GOROman/claude-pcb/docs/img/render-top.png

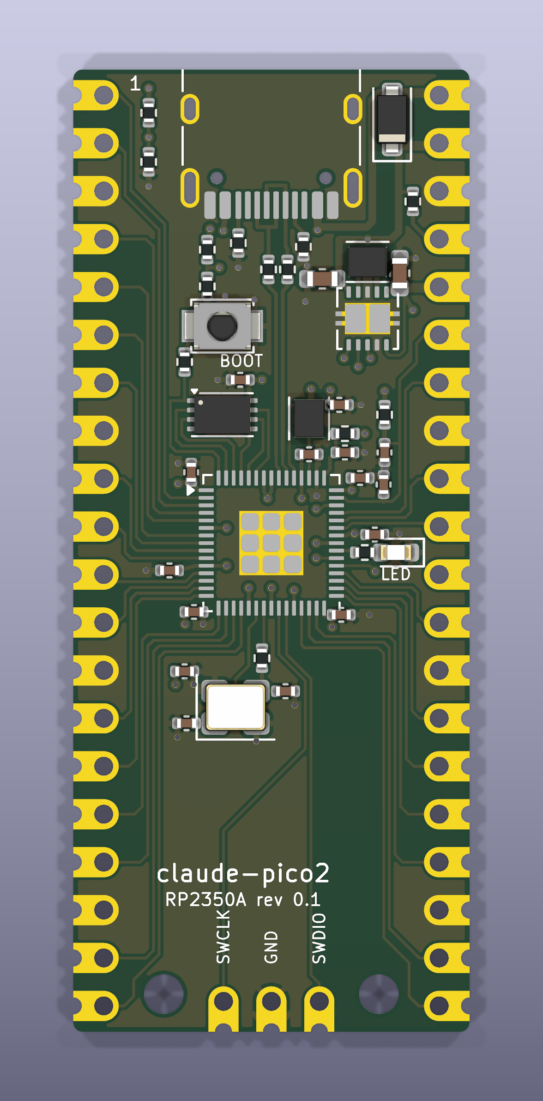
docs/img/render-top.png
