GOROman/claude-pcb/docs/img/render-iso.png

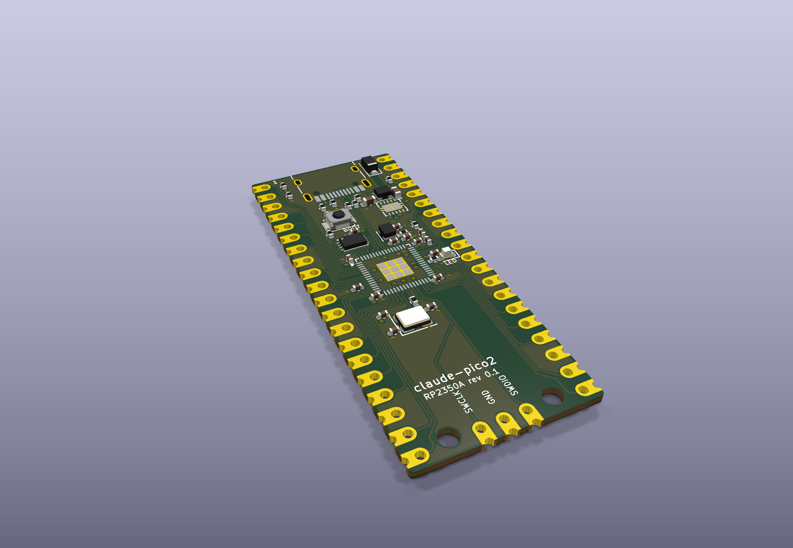
docs/img/render-iso.png
