GOROman/claude-pcb/docs/img/layer-BCu.png

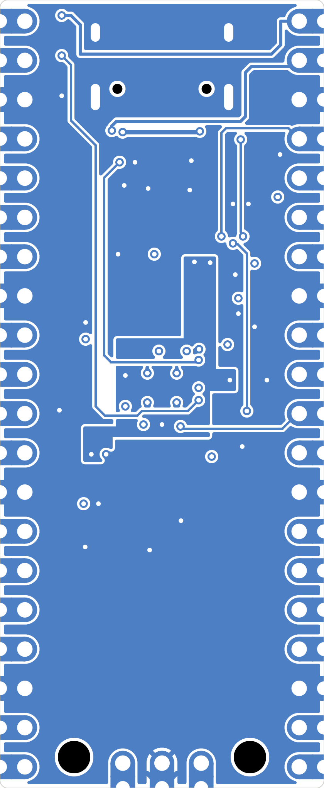
docs/img/layer-BCu.png
