GOROman/claude-pcb/docs/img/layer-FCu.png

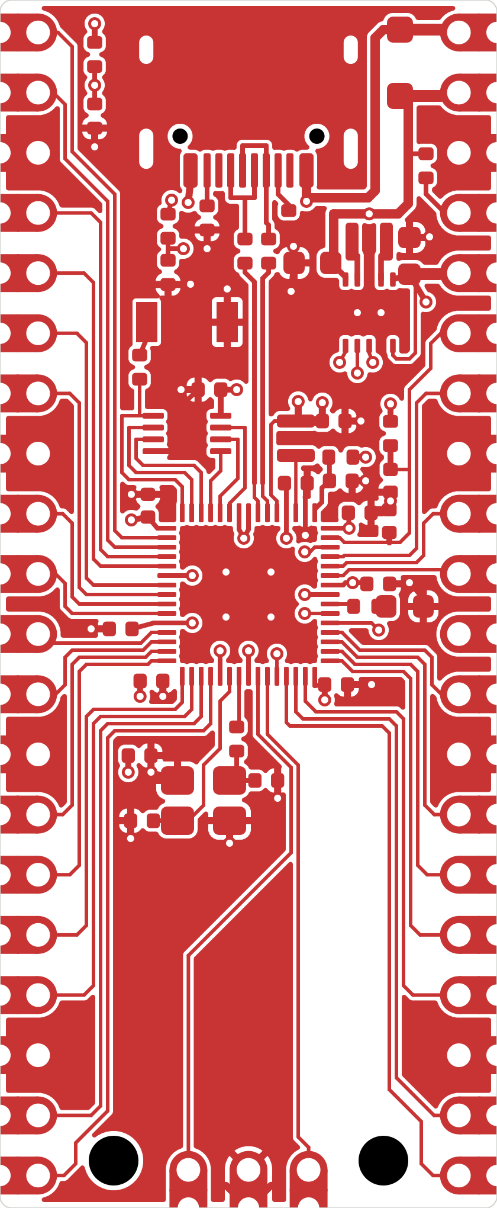
docs/img/layer-FCu.png
