GOROman/claude-pcb/docs/img/layer-In1Cu.png

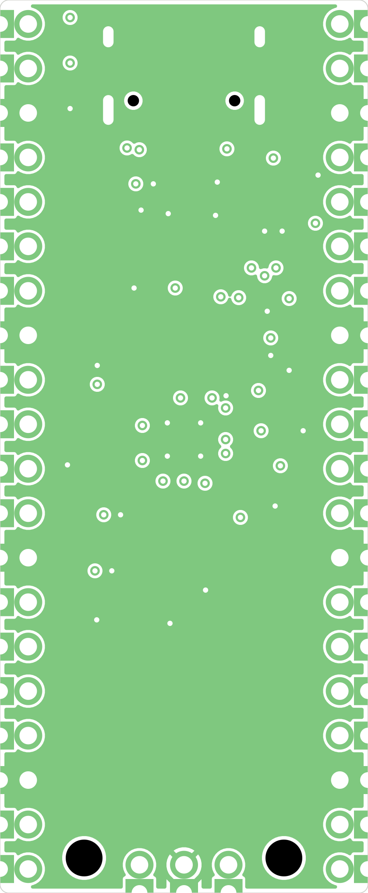
docs/img/layer-In1Cu.png
