GOROman/claude-pcb/docs/img/layer-In2Cu.png

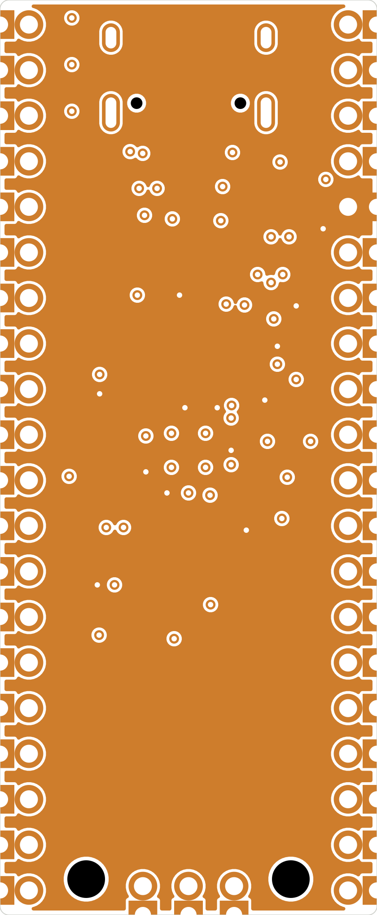
docs/img/layer-In2Cu.png
