GOROman/claude-pcb/docs/img/render-bottom.png

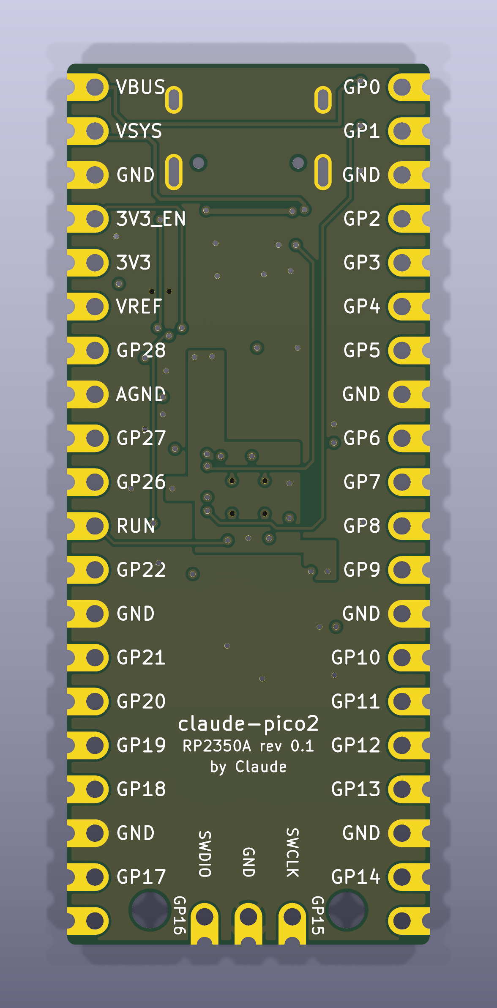
docs/img/render-bottom.png
