GOROman/claude-pcb/docs/img/schematic.png

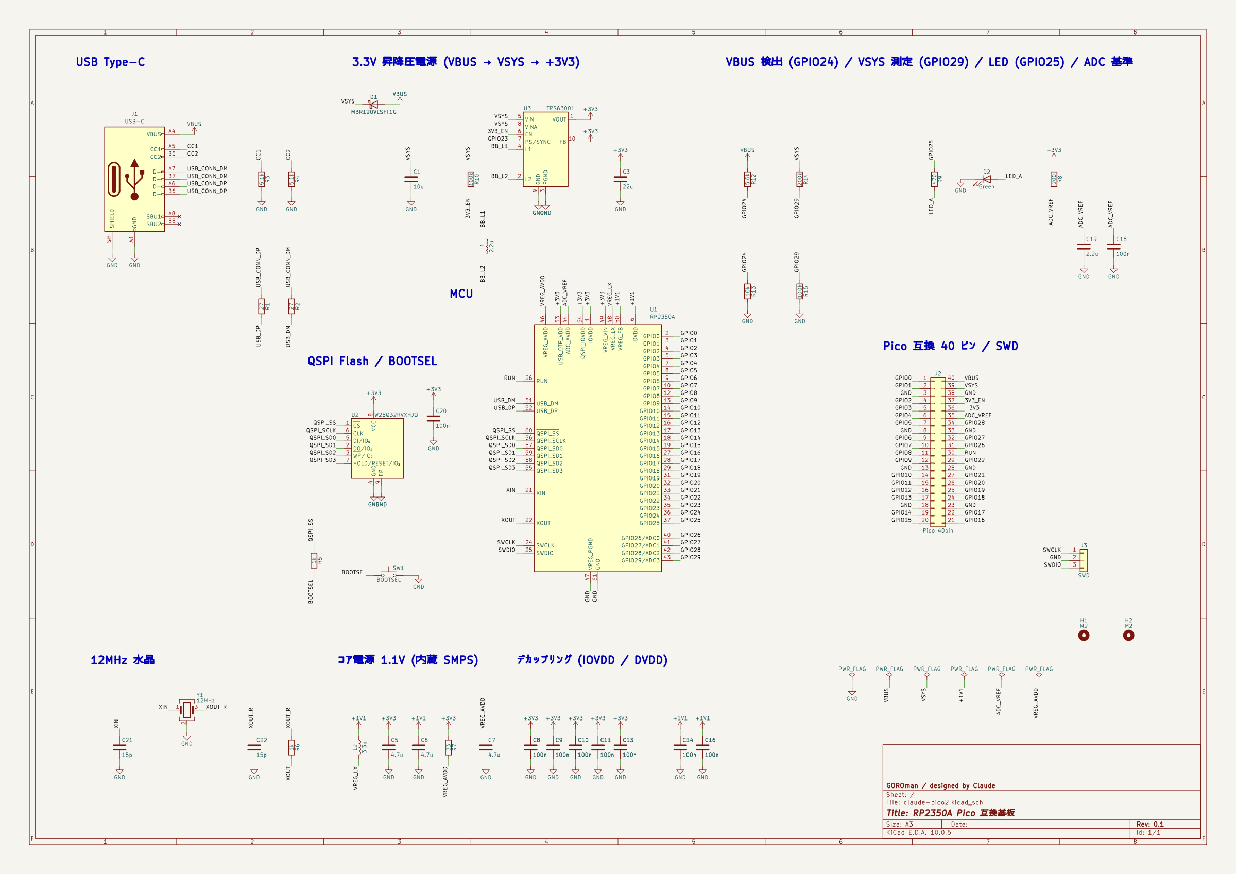
docs/img/schematic.png
