GOROman/claude-pcb/hardware/production/claude-pico2-bom.csv

Reference | Value | Footprint | MPN | Qty
C1 | 10u | Capacitor_SMD:C_0603_1608Metric |  | 1
C3 | 22u | Capacitor_SMD:C_0603_1608Metric |  | 1
C5,C6,C7 | 4.7u | Capacitor_SMD:C_0402_1005Metric |  | 3
C8,C9,C10,C11,C13,C14,C16,C18,C20 | 100n | Capacitor_SMD:C_0402_1005Metric |  | 9
C19 | 2.2u | Capacitor_SMD:C_0402_1005Metric |  | 1
C21,C22 | 15p | Capacitor_SMD:C_0402_1005Metric |  | 2
D1 | MBR120VLSFT1G | Diode_SMD:D_SOD-123F | MBR120VLSFT1G | 1
D2 | Green | LED_SMD:LED_0603_1608Metric |  | 1
J1 | USB-C | Connector_USB:USB_C_Receptacle_HRO_TYPE-C-31-M-12 | TYPE-C-31-M-12 | 1
J2 | Pico 40pin | claude_pico:PicoEdge_40 |  | 1
J3 | SWD | claude_pico:PicoDebug_3 |  | 1
L1 | 2.2u | Inductor_SMD:L_Murata_DFE201610P | DFE201612E-2R2M | 1
L2 | 3.3u | Inductor_SMD:L_Murata_DFE201610P | AOTA-B201610S3R3-101-T | 1
R1,R2 | 27 | Resistor_SMD:R_0402_1005Metric |  | 2
R3,R4 | 5.1k | Resistor_SMD:R_0402_1005Metric |  | 2
R5,R6 | 1k | Resistor_SMD:R_0402_1005Metric |  | 2
R7 | 33 | Resistor_SMD:R_0402_1005Metric |  | 1
R8 | 200 | Resistor_SMD:R_0402_1005Metric |  | 1
R9 | 470 | Resistor_SMD:R_0402_1005Metric |  | 1
R10,R15 | 100k | Resistor_SMD:R_0402_1005Metric |  | 2
R12 | 5.6k | Resistor_SMD:R_0402_1005Metric |  | 1
R13 | 10k | Resistor_SMD:R_0402_1005Metric |  | 1
R14 | 200k | Resistor_SMD:R_0402_1005Metric |  | 1
SW1 | BOOTSEL | Button_Switch_SMD:SW_SPST_B3U-1000P | B3U-1000P | 1
U1 | RP2350A | Package_DFN_QFN:QFN-60-1EP_7x7mm_P0.4mm_EP3.4x3.4mm | RP2350A | 1
U2 | W25Q32RVXHJQ | Package_SON:Winbond_USON-8-1EP_3x2mm_P0.5mm_EP0.2x1.6mm | W25Q32RVXHJQ | 1
U3 | TPS63001 | Package_SON:Texas_DRC0010J | TPS63001DRCR | 1
Y1 | 12MHz | Crystal:Crystal_SMD_3225-4Pin_3.2x2.5mm | ABM8-272-T3 | 1
