GOROman/claude-pcb/docs/schematic.pdf

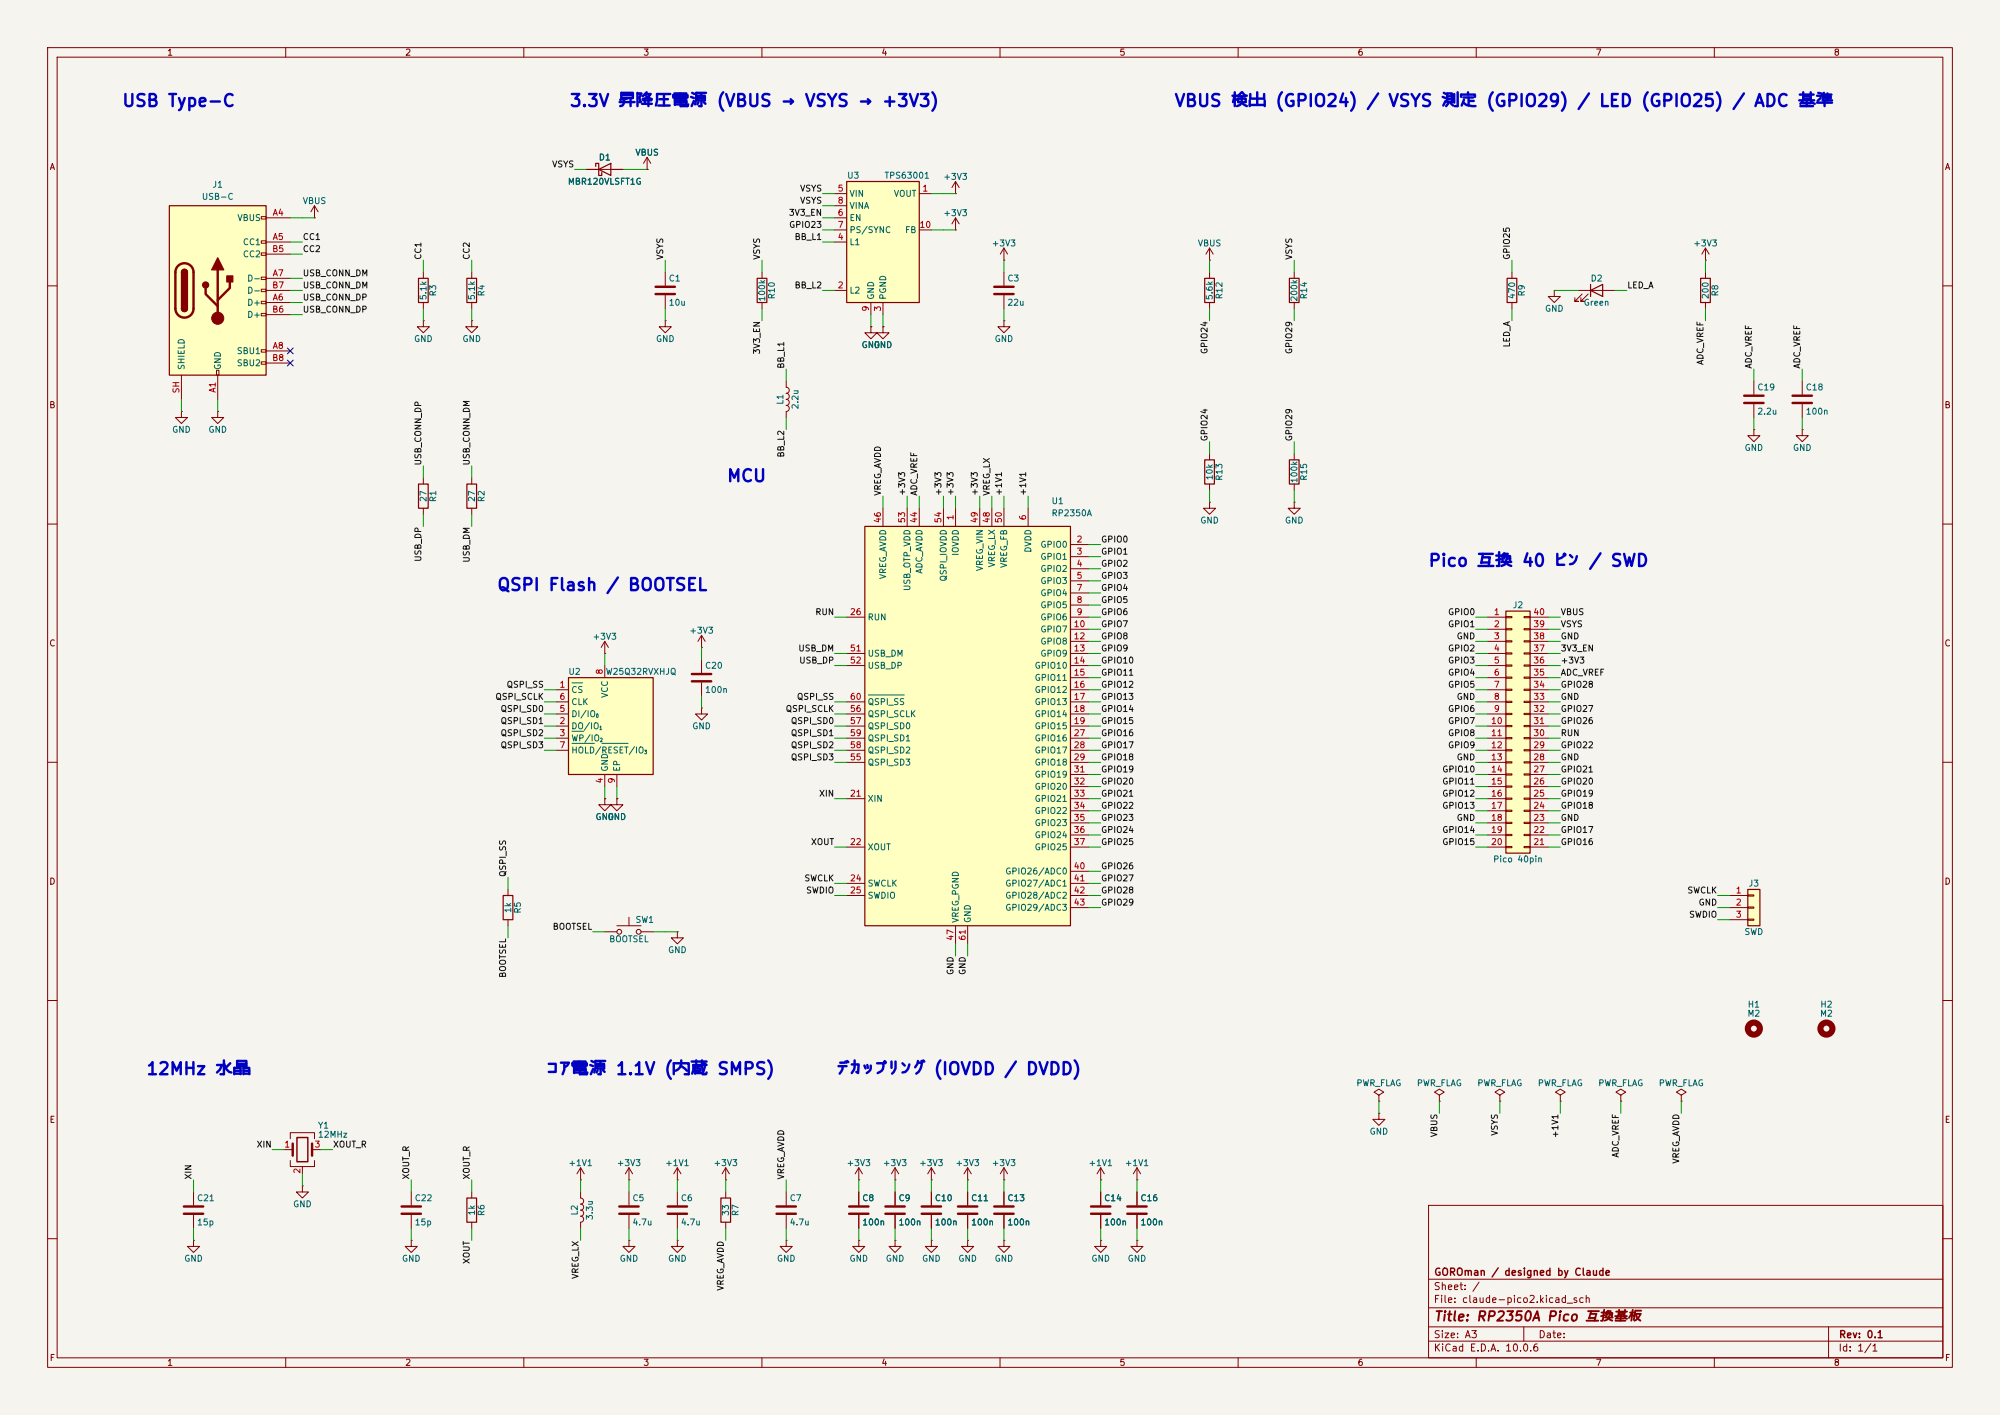
[picture p9: page 1]

VBUS 検出 (GPIO24) / VSYS 測定 (GPIO29) / LED (GPIO25) / ADC 基準

Pico 互換 40 ピン / SWD

4 DI/IO0 5 CLK 6 HOLD/RESET/IO3 7 VCC

GOROman / designed by Claude
Sheet: /
File: claude-pico2.kicad_sch
Title: RP2350A Pico 互換基板

Size: A3 | Rev: 0.1 | F Date:
KiCad E.D.A. 10.0.6 | Id: 1/1
