GOROman/claude-pcb/hardware/claude-pico2.kicad_pcb

## KiCad design hardware/claude-pico2.kicad_pcb (2026-11-10)

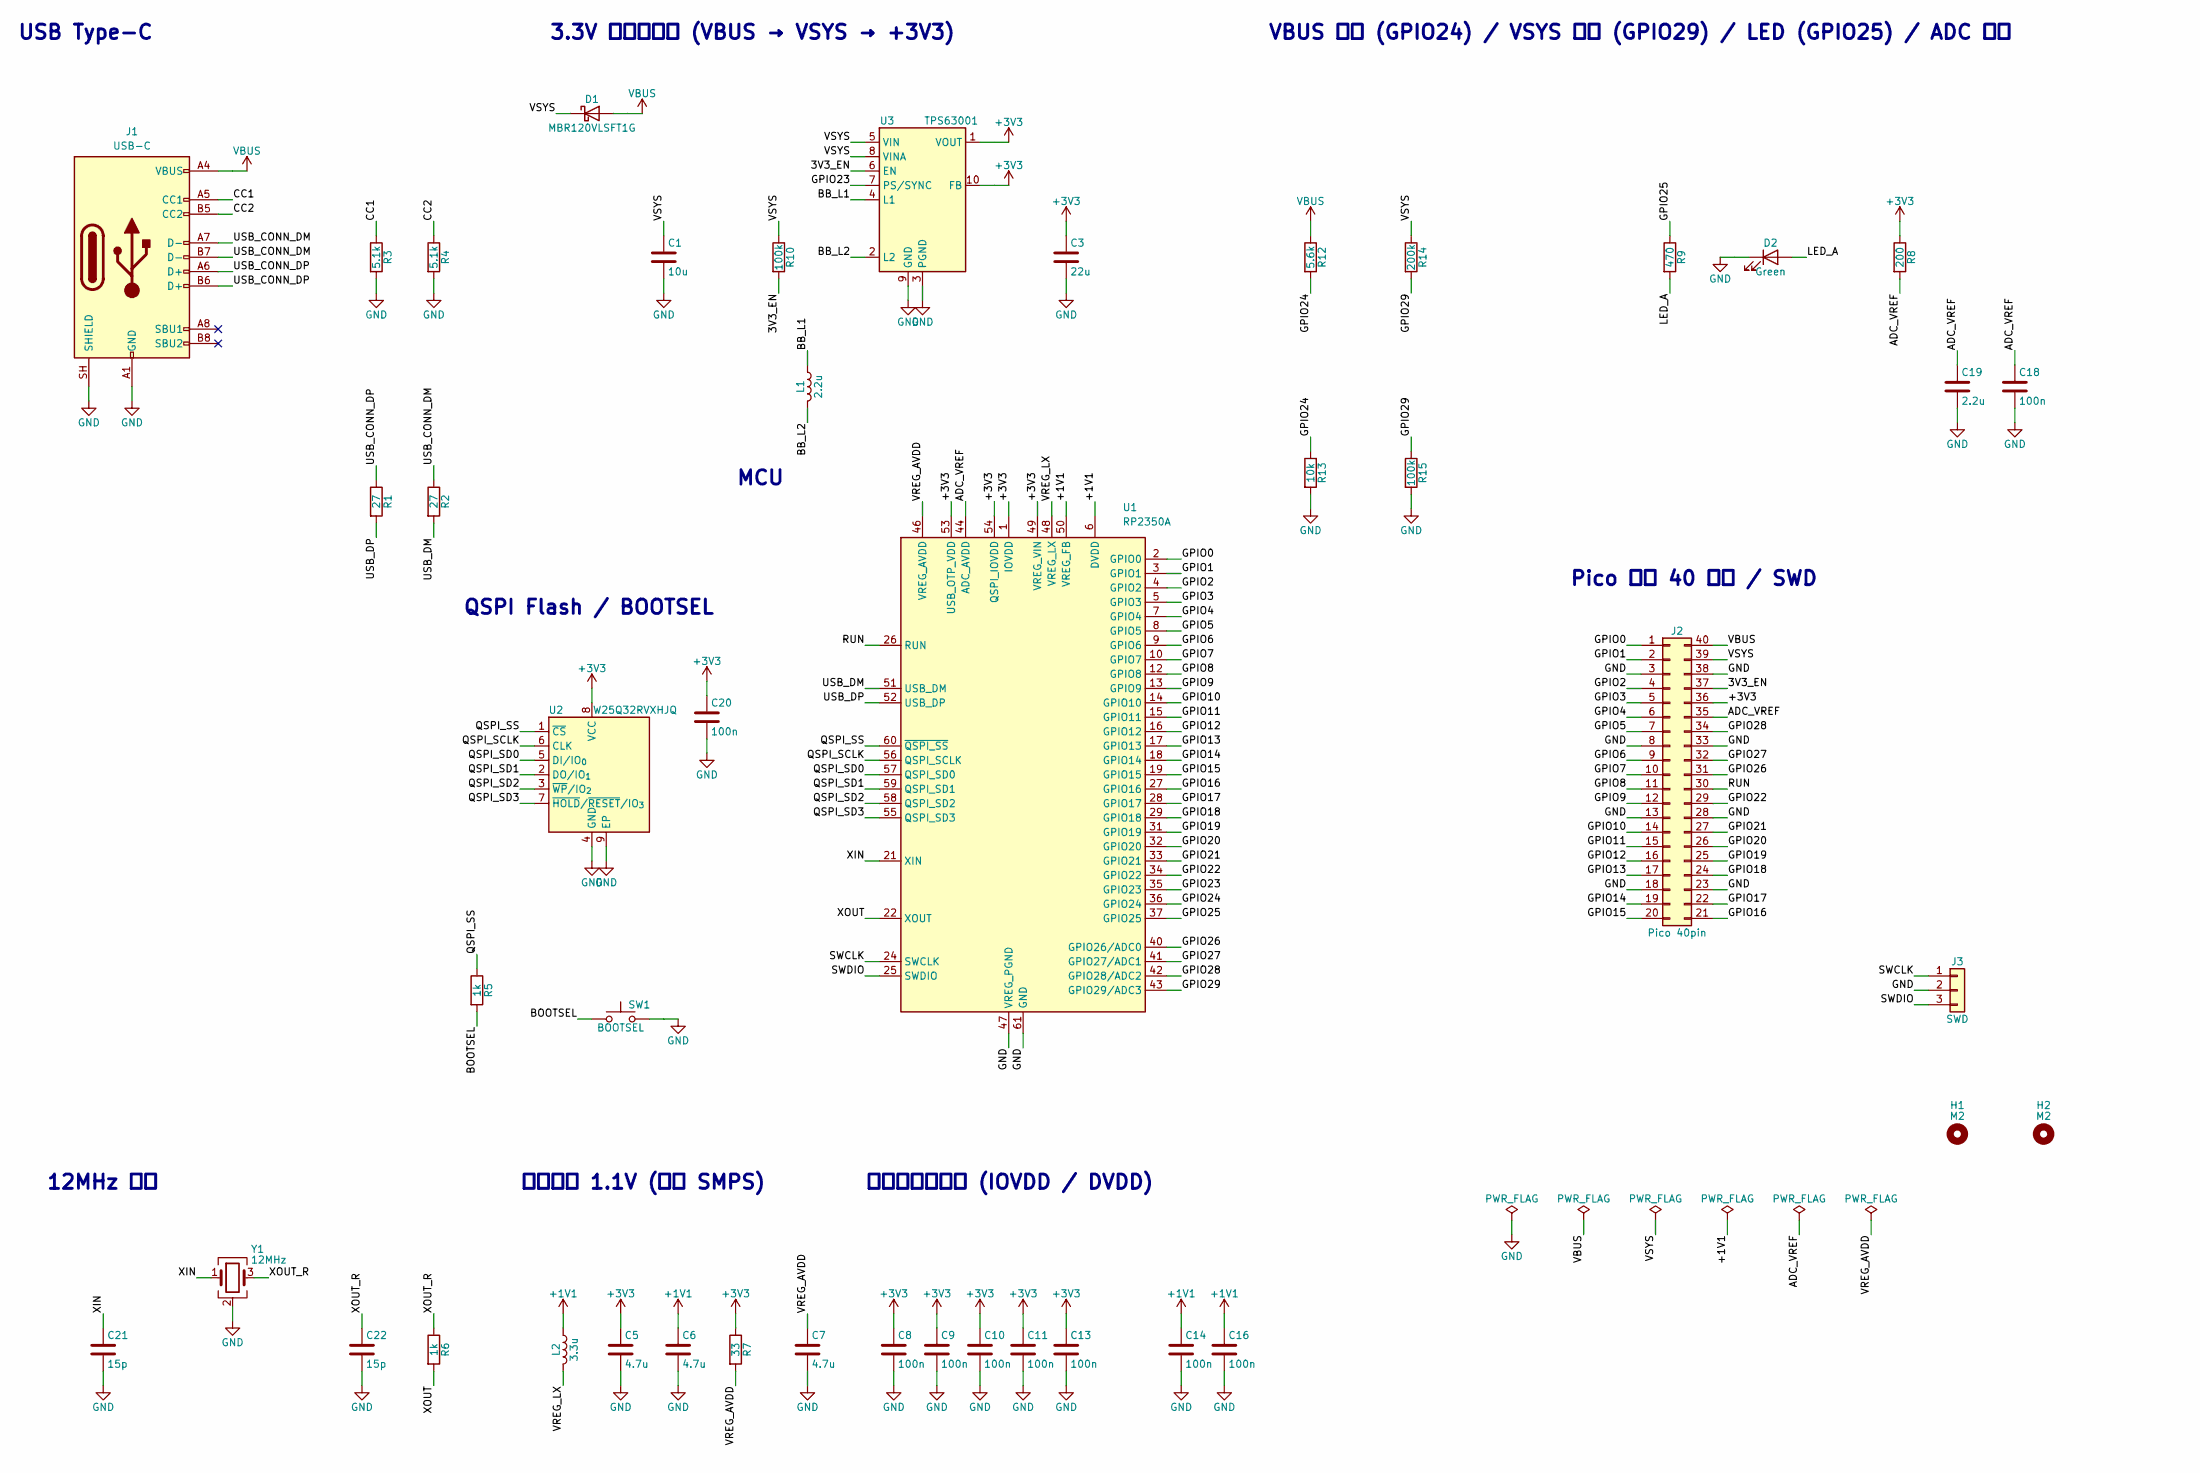
[picture p10: schematic claude-pico2.kicad_sch, RP2350A Pico 互換基板]

Parts:
C1: 10u; C_0603_1608Metric
C3: 22u; C_0603_1608Metric
C5, C6, C7: 4.7u; C_0402_1005Metric
C8, C9, C10, C11, C13, C14, C16, C18, C20: 100n; C_0402_1005Metric
C19: 2.2u; C_0402_1005Metric
C21, C22: 15p; C_0402_1005Metric
D1: MBR120VLSFT1G; D_SOD-123F; MPN MBR120VLSFT1G
D2: Green; LED_0603_1608Metric
H1, H2: M2; MountingHole_2.1mm
J1: USB-C; USB_C_Receptacle_HRO_TYPE-C-31-M-12; MPN TYPE-C-31-M-12
J2: Pico 40pin; PicoEdge_40
J3: SWD; PicoDebug_3
L1: 2.2u; L_Murata_DFE201610P; MPN DFE201612E-2R2M
L2: 3.3u; L_Murata_DFE201610P; MPN AOTA-B201610S3R3-101-T
R1, R2: 27; R_0402_1005Metric
R3, R4: 5.1k; R_0402_1005Metric
R5, R6: 1k; R_0402_1005Metric
R7: 33; R_0402_1005Metric
R8: 200; R_0402_1005Metric
R9: 470; R_0402_1005Metric
R10, R15: 100k; R_0402_1005Metric
R12: 5.6k; R_0402_1005Metric
R13: 10k; R_0402_1005Metric
R14: 200k; R_0402_1005Metric
SW1: BOOTSEL; SW_SPST_B3U-1000P; MPN B3U-1000P
U1: RP2350A; QFN-60-1EP_7x7mm_P0.4mm_EP3.4x3.4mm; MPN RP2350A
U2: W25Q32RVXHJQ; Winbond_USON-8-1EP_3x2mm_P0.5mm_EP0.2x1.6mm; MPN W25Q32RVXHJQ
U3: TPS63001; Texas_DRC0010J; MPN TPS63001DRCR
Y1: 12MHz; Crystal_SMD_3225-4Pin_3.2x2.5mm; MPN ABM8-272-T3

Connections:
+1V1: C6.1, C14.1, C16.1, L2.1, U1.6 (DVDD), U1.23 (DVDD), U1.39 (DVDD), U1.50 (VREG_FB)
+3V3: C3.1, C5.1, C8.1, C9.1, C10.1, C11.1, C13.1, C20.1, J2.36, R7.1, R8.1, U1.1 (IOVDD), U1.11 (IOVDD), U1.20 (IOVDD), U1.30 (IOVDD), U1.38 (IOVDD), U1.45 (IOVDD), U1.49 (VREG_VIN), U1.53 (USB_OTP_VDD), U1.54 (QSPI_IOVDD), U2.8 (VCC), U3.1 (VOUT), U3.10 (FB)
/3V3_EN: J2.37, R10.2, U3.6 (EN)
/ADC_VREF: C18.1, C19.1, J2.35, R8.2, U1.44 (ADC_AVDD)
/BB_L1: L1.1, U3.4 (L1)
/BB_L2: L1.2, U3.2 (L2)
/BOOTSEL: R5.2, SW1.1
/CC1: J1.A5 (CC1), R3.1
/CC2: J1.B5 (CC2), R4.1
/GPIO0: J2.1, U1.2 (GPIO0)
/GPIO1: J2.2, U1.3 (GPIO1)
/GPIO2: J2.4, U1.4 (GPIO2)
/GPIO3: J2.5, U1.5 (GPIO3)
/GPIO4: J2.6, U1.7 (GPIO4)
/GPIO5: J2.7, U1.8 (GPIO5)
/GPIO6: J2.9, U1.9 (GPIO6)
/GPIO7: J2.10, U1.10 (GPIO7)
/GPIO8: J2.11, U1.12 (GPIO8)
/GPIO9: J2.12, U1.13 (GPIO9)
/GPIO10: J2.14, U1.14 (GPIO10)
/GPIO11: J2.15, U1.15 (GPIO11)
/GPIO12: J2.16, U1.16 (GPIO12)
/GPIO13: J2.17, U1.17 (GPIO13)
/GPIO14: J2.19, U1.18 (GPIO14)
/GPIO15: J2.20, U1.19 (GPIO15)
/GPIO16: J2.21, U1.27 (GPIO16)
/GPIO17: J2.22, U1.28 (GPIO17)
/GPIO18: J2.24, U1.29 (GPIO18)
/GPIO19: J2.25, U1.31 (GPIO19)
/GPIO20: J2.26, U1.32 (GPIO20)
/GPIO21: J2.27, U1.33 (GPIO21)
/GPIO22: J2.29, U1.34 (GPIO22)
/GPIO23: U1.35 (GPIO23), U3.7 (PS/SYNC)
/GPIO24: R12.2, R13.1, U1.36 (GPIO24)
/GPIO25: R9.1, U1.37 (GPIO25)
/GPIO26: J2.31, U1.40 (GPIO26/ADC0)
/GPIO27: J2.32, U1.41 (GPIO27/ADC1)
/GPIO28: J2.34, U1.42 (GPIO28/ADC2)
/GPIO29: R14.2, R15.1, U1.43 (GPIO29/ADC3)
/LED_A: D2.2 (A), R9.2
/QSPI_SCLK: U1.56 (QSPI_SCLK), U2.6 (CLK)
/QSPI_SD0: U1.57 (QSPI_SD0), U2.5 (DI/IO_{0})
/QSPI_SD1: U1.59 (QSPI_SD1), U2.2 (DO/IO_{1})
/QSPI_SD2: U1.58 (QSPI_SD2), U2.3 (~WP/IO_{2})
/QSPI_SD3: U1.55 (QSPI_SD3), U2.7 (~HOLD/~RESET/IO_{3})
/QSPI_SS: R5.1, U1.60 (~QSPI_SS), U2.1 (~CS)
/RUN: J2.30, U1.26 (RUN)
/SWCLK: J3.1, U1.24 (SWCLK)
/SWDIO: J3.3, U1.25 (SWDIO)
/USB_CONN_DM: J1.A7 (D-), J1.B7 (D-), R2.1
/USB_CONN_DP: J1.A6 (D+), J1.B6 (D+), R1.1
/USB_DM: R2.2, U1.51 (USB_DM)
/USB_DP: R1.2, U1.52 (USB_DP)
/VREG_AVDD: C7.1, R7.2, U1.46 (VREG_AVDD)
/VREG_LX: L2.2, U1.48 (VREG_LX)
/VSYS: C1.1, D1.1 (K), J2.39, R10.1, R14.1, U3.5 (VIN), U3.8 (VINA)
/XIN: C21.1, U1.21 (XIN), Y1.1
/XOUT: R6.2, U1.22 (XOUT)
/XOUT_R: C22.1, R6.1, Y1.3
GND: C1.2, C3.2, C5.2, C6.2, C7.2, C8.2, C9.2, C10.2, C11.2, C13.2, C14.2, C16.2, C18.2, C19.2, C20.2, C21.2, C22.2, D2.1 (K), J1.A1 (GND), J1.A12 (GND), J1.B1 (GND), J1.B12 (GND), J1.SH (SHIELD), J2.3, J2.8, J2.13, J2.18, J2.23, J2.28, J2.33, J2.38, J3.2, R3.2, R4.2, R13.2, R15.2, SW1.2, U1.47 (VREG_PGND), U1.61 (GND), U2.4 (GND), U2.9 (EP), U3.3 (PGND), U3.9 (GND), U3.11 (PGND), Y1.2 (G), Y1.4 (G)
VBUS: D1.2 (A), J1.A4 (VBUS), J1.A9 (VBUS), J1.B4 (VBUS), J1.B9 (VBUS), J2.40, R12.1

Notes on the sheet:
USB Type-C
3.3V 昇降圧電源 (VBUS → VSYS → +3V3)
VBUS 検出 (GPIO24) / VSYS 測定 (GPIO29) / LED (GPIO25) / ADC 基準
QSPI Flash / BOOTSEL
MCU
Pico 互換 40 ピン / SWD
12MHz 水晶
コア電源 1.1V (内蔵 SMPS)
デカップリング (IOVDD / DVDD)

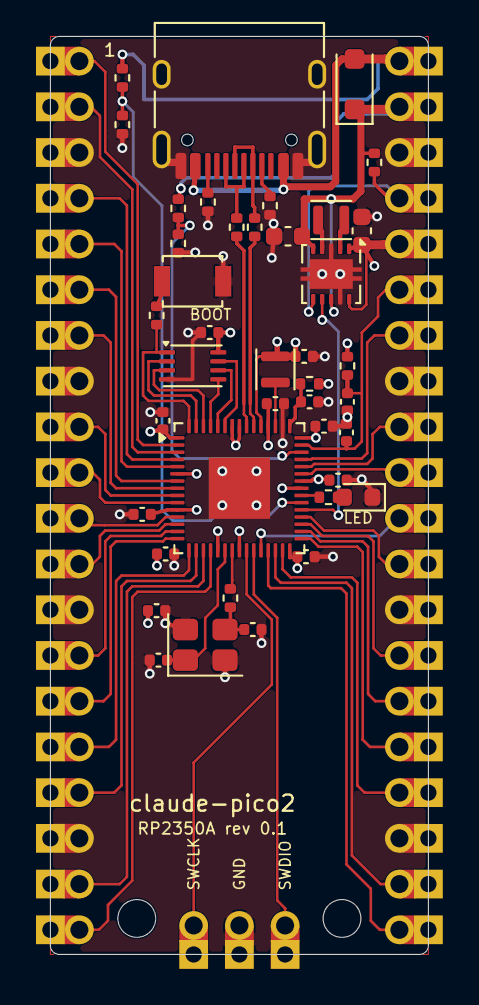
[picture p11: board claude-pico2.kicad_pcb from above]

Board: 4 copper layers, 21.0 x 51.0 mm, 45 parts (0 on the bottom side), 61 nets.
