GOROman/claude-pcb/(commit log)

2026-11-10 プロジェクト開始: 方針・仕様と KiCad ライブラリ調査ツール
2026-11-10 回路定義と回路図ジェネレータを追加 (ERC 電気的エラー 0)
    [claude-pico2.kicad_sch]
2026-11-10 基板の配置と配線: 4 層、DRC 未接続 0 / 回路図不一致 0
    - 独自フットプリント (端面スルーホール付き 40 ピン / SWD)
    - GPIO ファンアウト、QSPI、USB、電源、裏面配線、ベタ
    - 回路を整理 (Q1 等を削除、LED を右辺へ)
    [claude-pico2.kicad_pcb, claude-pico2.kicad_sch]
2026-11-10 シルク、製造データ、レンダリング、README を追加 (rev 0.1)
    - 裏面にピン名、表面にラベル
    - tools/build.sh: 生成 → ERC/DRC → ガーバー/ドリル/BOM/座標/PDF/レンダリング
    - ベタ塗り前に接続情報を構築して結果を安定化
    - remote.sh をリモート出力ファイル経由に変更
    - README に検証結果と発注前の確認事項を記載
    [claude-pico2-B_Cu.gbr, claude-pico2-B_Mask.gbr, claude-pico2-B_Paste.gbr, claude-pico2-B_Silkscreen.gbr, claude-pico2-Edge_Cuts.gbr, claude-pico2-F_Cu.gbr, claude-pico2-F_Mask.gbr, claude-pico2-F_Paste.gbr]
